DaanDekoningKrekels/ci-poc-TinySalinity/Workshop.pdf

# Internet of Things Workshop

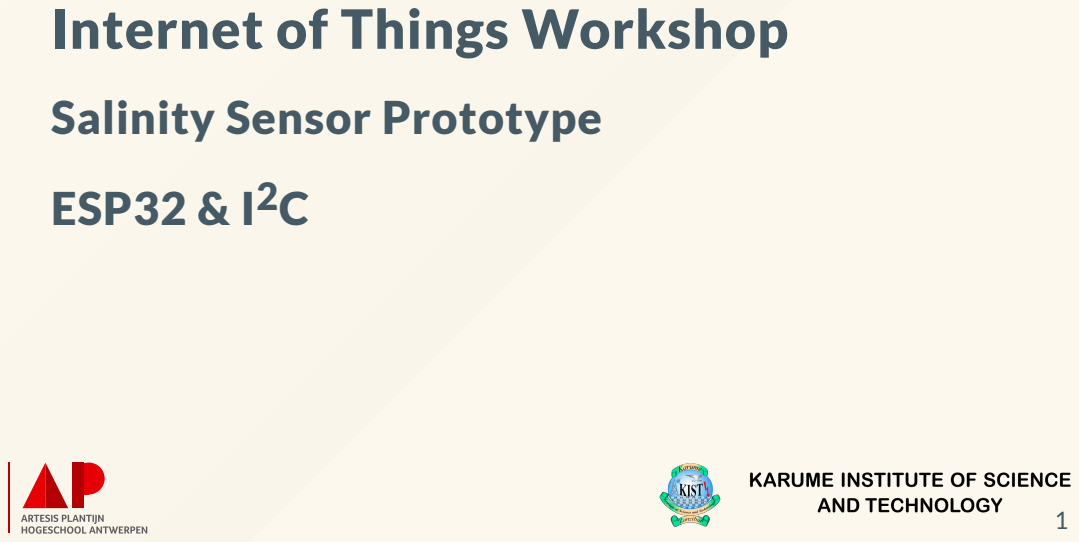
[picture p9: page 1]

Salinity Sensor Prototype
ESP32 & I

## Salinity Sensor

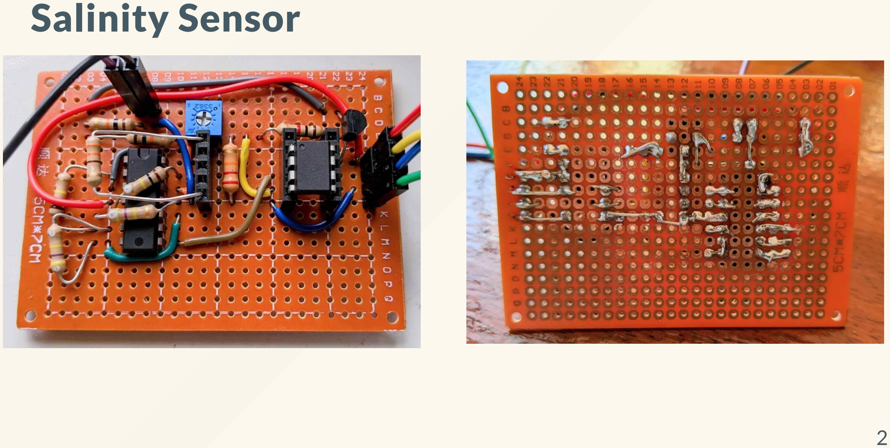
[picture p10: page 2]

## Salinity Sensor

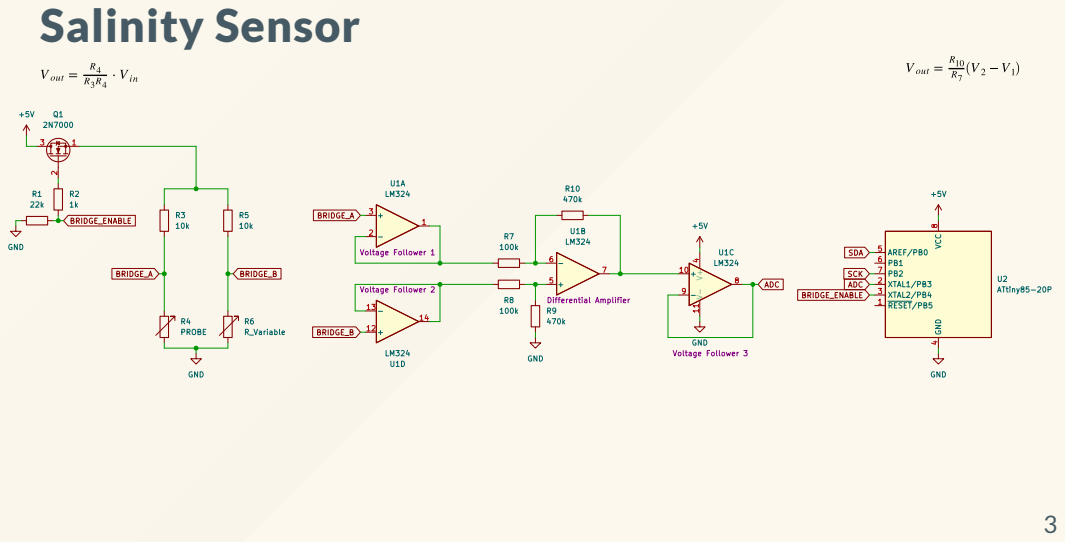
[picture p11: page 3]

## Wheatstone bridge

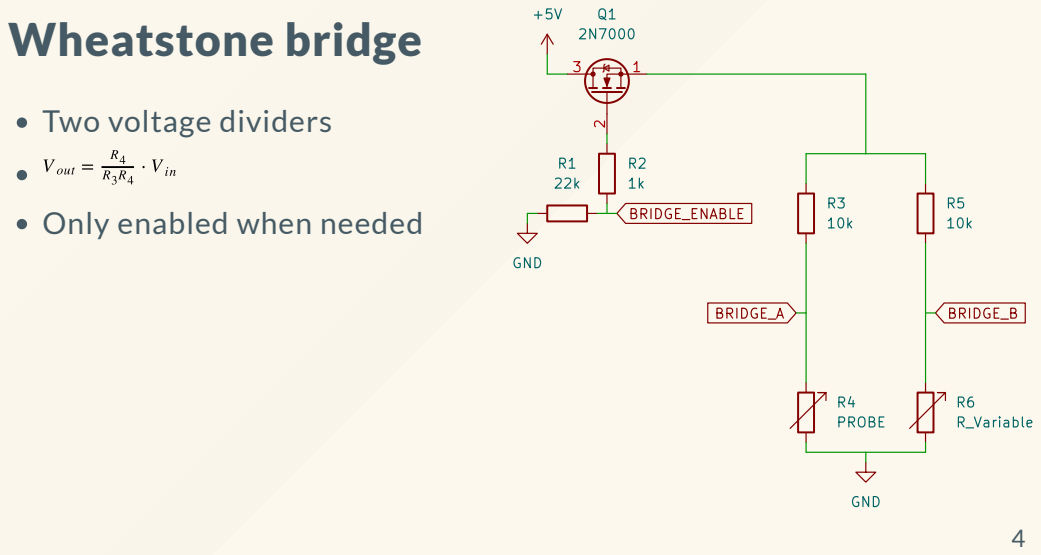
[picture p12: page 4]

Two voltage dividers

Only enabled when needed

## Amplifier

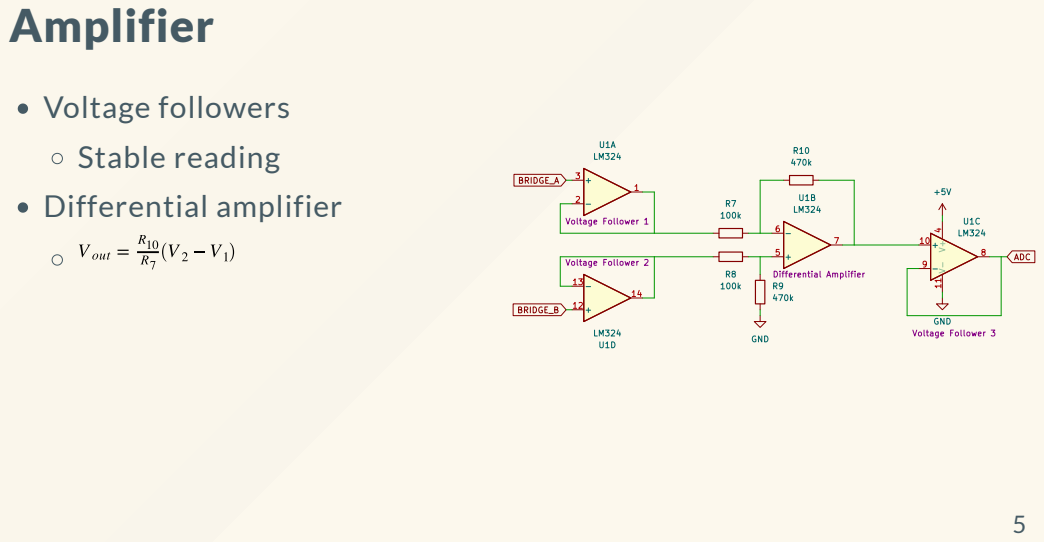
[picture p13: page 5]
Voltage followers; Stable reading Differential amplifier

## ATtiny

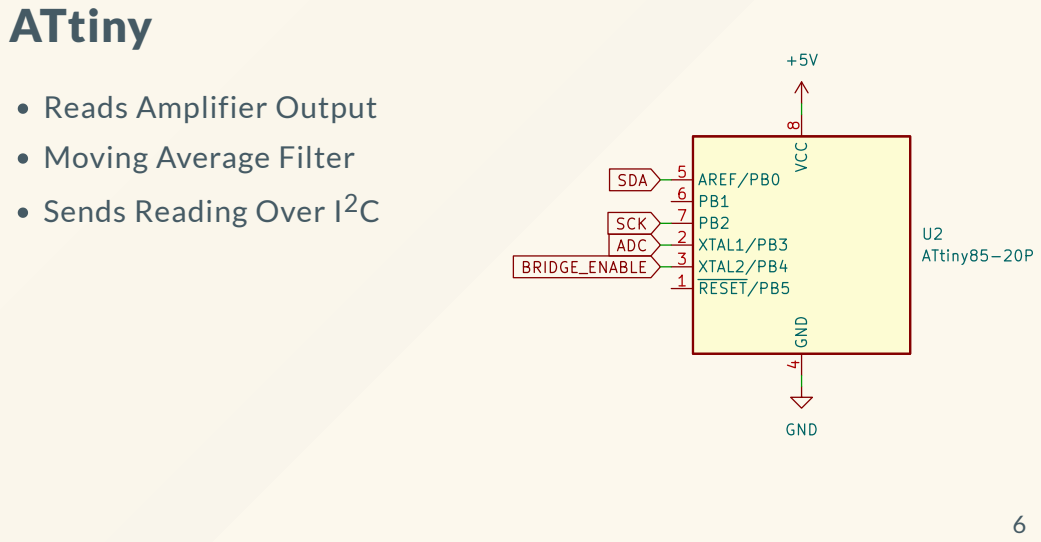
[picture p14: page 6]

Reads Amplifier Output
Moving Average Filter
Sends Reading Over I

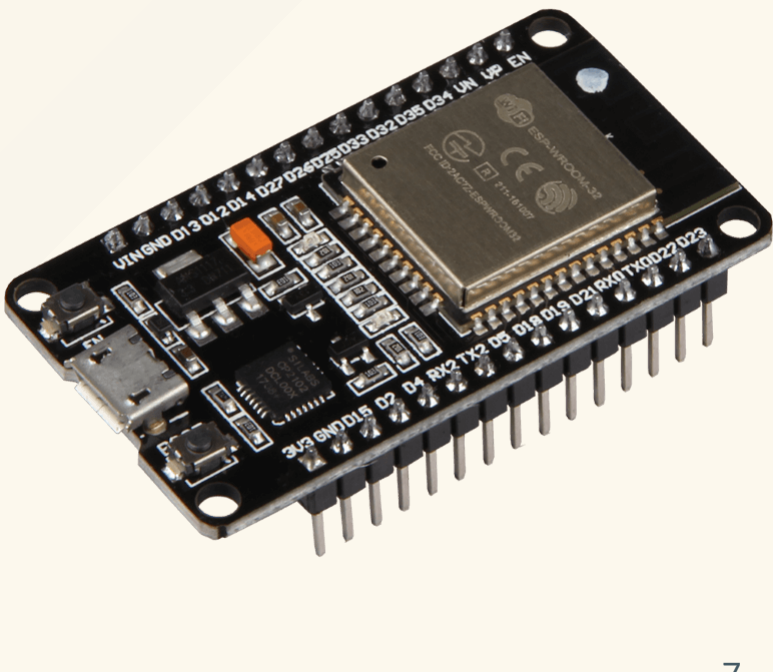
[picture p15: figure]

## ESP32 DOIT V1

Microcontroller
Arduino + WiFi & Bluetooth 30 pins

## Setting up the Arduino IDE

1. https://www.arduino.cc/en/software
2. Open " File | > | Preferences | > | Additional Board Manager URLs

" and
add: https://dl.espressif.com/dl/package_esp32_index.json
3. Open the Boards Manager at " Tools | > | Board | > | Boards Manager

"

,
search for "ESP32" and press the install button for "ESP32 by Espressif Systems"

## Testing Arduino IDE

1. Select " DOIT ESP32 DEVKIT V1 | " at " Tools | > | Board | "
2. Select the correct COM port under " Tools | > | Port | "
3. Choose an example program in " File | > | Examples | >
Examples for DOIT ESP32 DEVKIT V1 | > | WiFi | > | WiFiScan

"
4. Program the code to the ESP32 with the Upload button ( )
5. Open the Serial Monitor via " Tools | > | Serial Monitor

" and set the
Baud-rate to "115200 baud"
6. If you can see the nearby WiFi networks everything is working!
Source: https://microcontrollerslab.com/install-esp32-arduino-ide/ | 9

## Soldering the Salinity Sensor

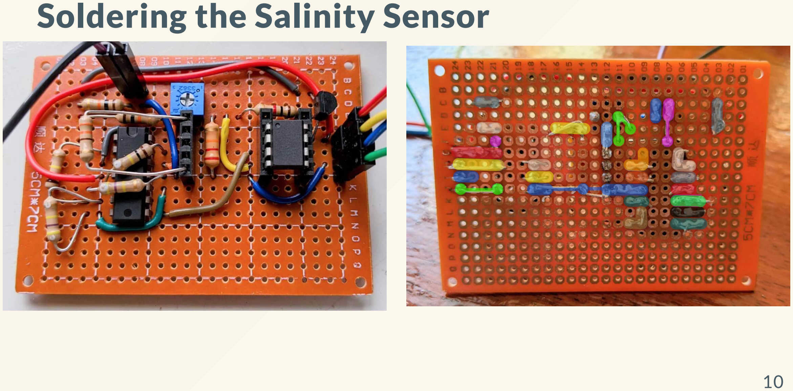
[picture p16: page 10]
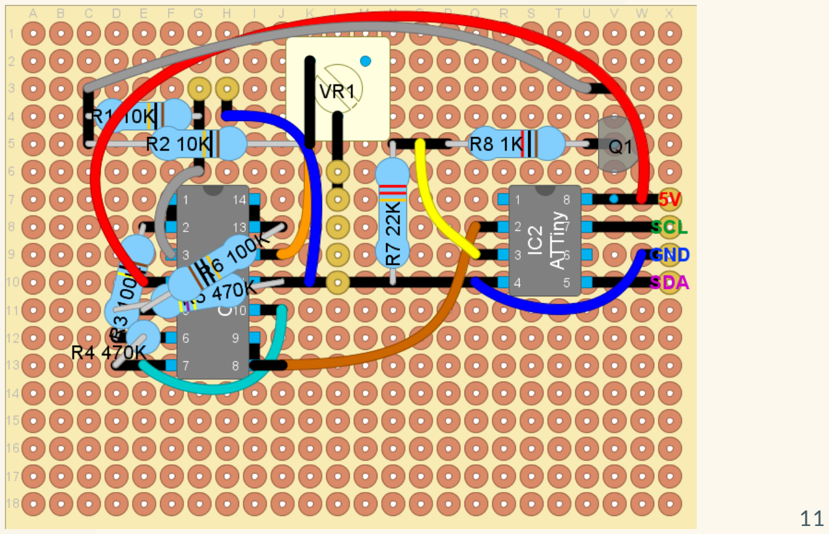
[picture p17: page 11]

# Connecting to the Salinity Sensor

## Using I

## 2C and an ESP32

I

2C

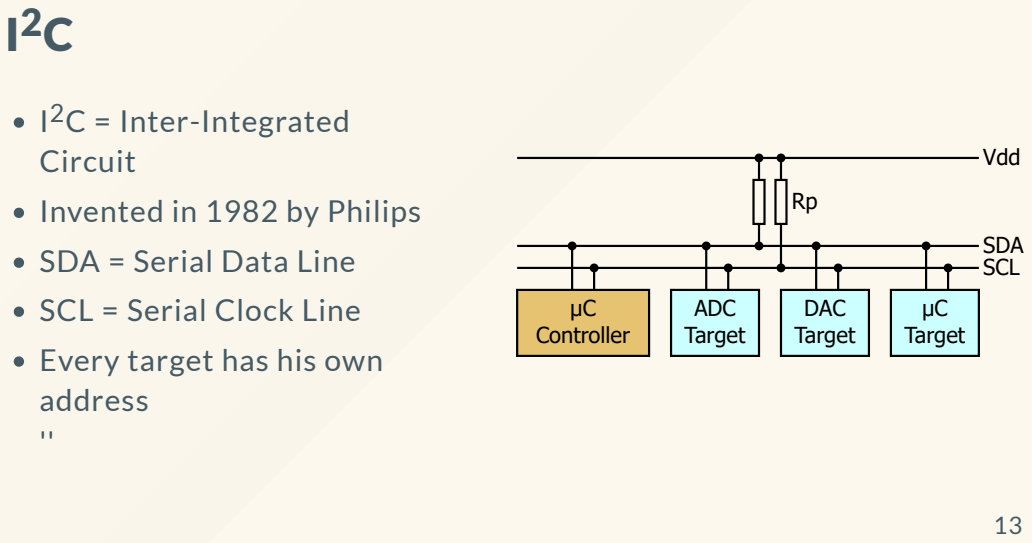
[picture p18: page 13]
ADC Target; DAC Target; µC Target; Vdd; SDA SCL; µC Controller

2C = Inter-Integrated
Circuit
Invented in 1982 by Philips
SDA = Serial Data Line
SCL = Serial Clock Line
Every target has his own
address

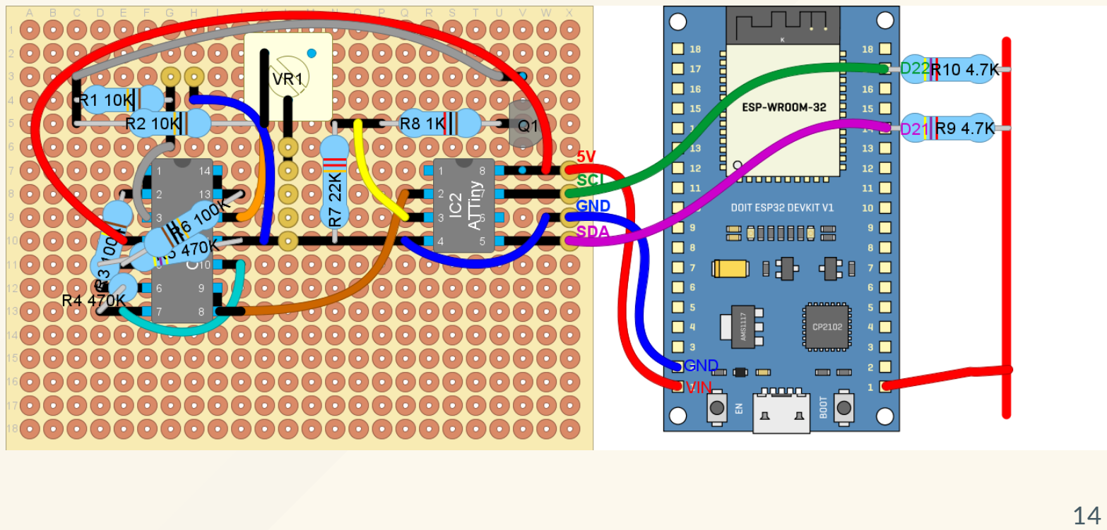
[picture p19: page 14]

## Send to serial monitor

void setup() {
// put your setup code here, to run once:

}

void loop() {
// put your main code here, to run repeatedly:

}

## Send to serial monitor

void setup() {
Serial.begin(115200); // Open the serial port at 115200 baud }

/* Send "Salamu, Dunia!" via serial every second. */
void loop() {
Serial.println("Salamu, Dunia!"); // Send text over the serial port delay(1000); // Wait 1000ms or 1s
}
