DaanDekoningKrekels/ci-poc-TinySalinity/BOM.md

# Zoutwatersensor BOM

- [x] - LM324 of pin compatiebele quad-opamp (TL074)
- [x] - ATTiny85
- [ ] - 8 pin & 14 pin dip-socket
- [x] - Weerstanden
	- [x] 	2x 10k
	- [x] 	2x 100k
	- [x] 	2x 470k
	- [x] 	1x 500k/200k pot/normale weerstand
