DaanDekoningKrekels/ci-poc-TinySalinity/(list of files, drawings)

Other design files:
Schema.ms14
