DaanDekoningKrekels/ci-poc-TinySalinity/(commit log)

2022-04-20 Added Workshop document
    [Schema.ms14]
2022-04-20 Salinity sensor photo back traced
2022-04-21 Update soldering trace + pinouts + test code ESP32 and I2C
2022-04-21 Code ESP32 for LoRa
2022-04-21 Update ESP32 connection
2022-04-25 Update README.md, added Prototype info
